craic/arduino_power/images/arduino_power_breadboard_1.png

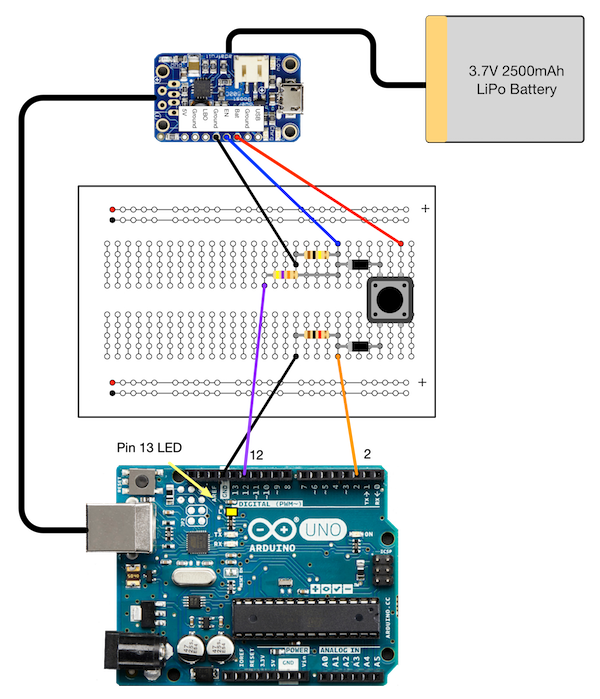
images/arduino_power_breadboard_1.png
