craic/arduino_power/images/breadboard_2_photo.png

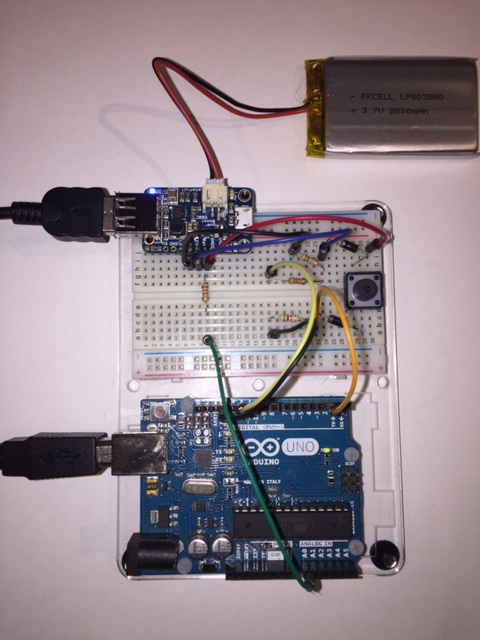
images/breadboard_2_photo.png
