craic/arduino_power/(commit log)

2016-10-07 add simple power on / power off example
2016-11-16 add enable pin photo
2016-11-16 add voltage pin photo
2016-11-16 split out the PowerBoost page
2016-11-21 add Power Up / Power Down to README
2016-11-21 add power on / power off schematic
2016-11-21 add power on / power off breadboard
2016-11-22 split out PowerOnPowerOff page
2016-12-01 update images for the interrupt circuit
2016-12-02 finish adding interrupt version of power on / power off
2016-12-02 add led schematic
2016-12-02 add led breadboard
2016-12-08 add voltage graphs
2016-12-09 add info about Powerboost breakout boards
2016-12-15 fix issue with filename length
    [arduino_3_voltage_logging.ino, arduino_4_voltage_temp_humidity_logging.ino]
